rishigovindnair-web/focus-totem/cad/focus_totem_assembly.step

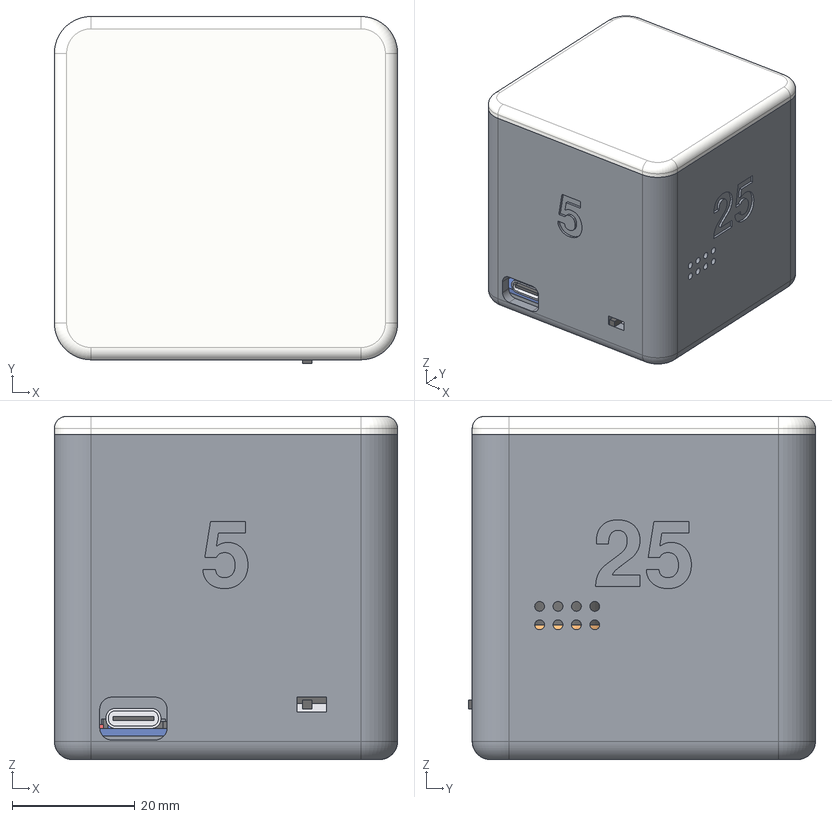
[picture p8: CAD file, 2026-11-09]
cad/focus_totem_assembly.step
56.0 x 56.6 x 56.0 mm
lid
sled
pcb x 4
pads
esp32c3
flash_xtal
antenna
ldo
led x 2
btn_boot_base
btn_boot_cap
btn_rst_base
btn_rst_cap
usb_shell x 2
usb_tongue x 2
header_pads
mount_rings
mpu6050
ldo_662k
passive0
passive1
passive2
passive3
passive4
passive5
led00
lens00
led01
lens01
led02
lens02
led03
lens03
led04
lens04
led05
lens05
led06
lens06
led07
lens07
led08
lens08
led09
lens09
led10
lens10
led11
lens11
tp4056_ic
dw01
fs8205a
led_chg
led_done
r_prog
pad_in+
pad_in-
pad_b+
pad_b-
pad_out-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
