rishigovindnair-web/focus-totem/cad/focus_totem_lid.step

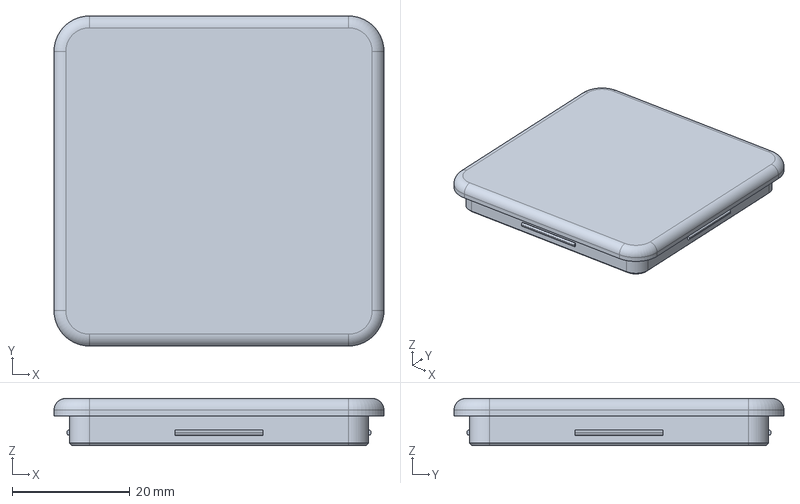
[picture p9: CAD file, 2026-11-09]
cad/focus_totem_lid.step
56.0 x 56.0 x 8.00 mm
