rishigovindnair-web/focus-totem/cad/focus_totem_body.step

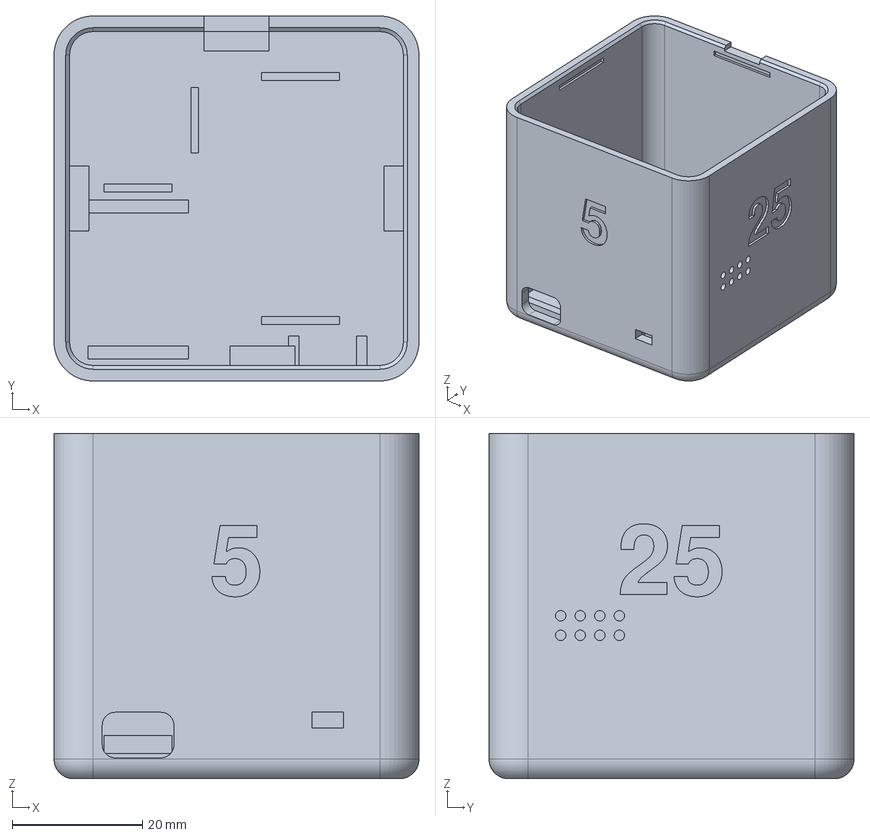
[picture p10: CAD file, 2026-11-09]
cad/focus_totem_body.step
56.0 x 56.0 x 53.0 mm
