rishigovindnair-web/focus-totem/cad/focus_totem_sled.step

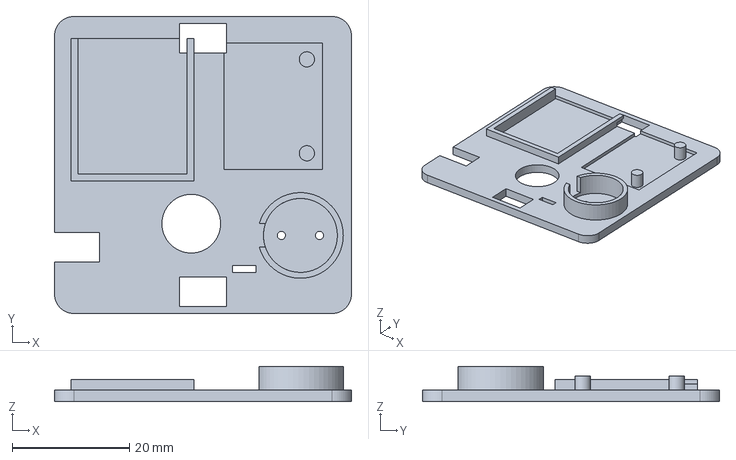
[picture p11: CAD file, 2026-11-09]
cad/focus_totem_sled.step
50.6 x 50.6 x 6.00 mm
