rishigovindnair-web/focus-totem/(list of files, cad)

Other CAD files:
cad/focus_totem_body.stl
cad/focus_totem_lid.stl
cad/focus_totem_sled.stl
